hmbusch/ESP8266-WirelessSensorNetwork/README.md

# ESP8266-WirelessSensorNetwork
An ESP8266-based environment monitoring solution using wireless sensors and a graphical dashboard.
