hmbusch/ESP8266-WirelessSensorNetwork/hardware/wireless-sensor-node.brd

## EAGLE design hardware/wireless-sensor-node.brd (2016-09-16)

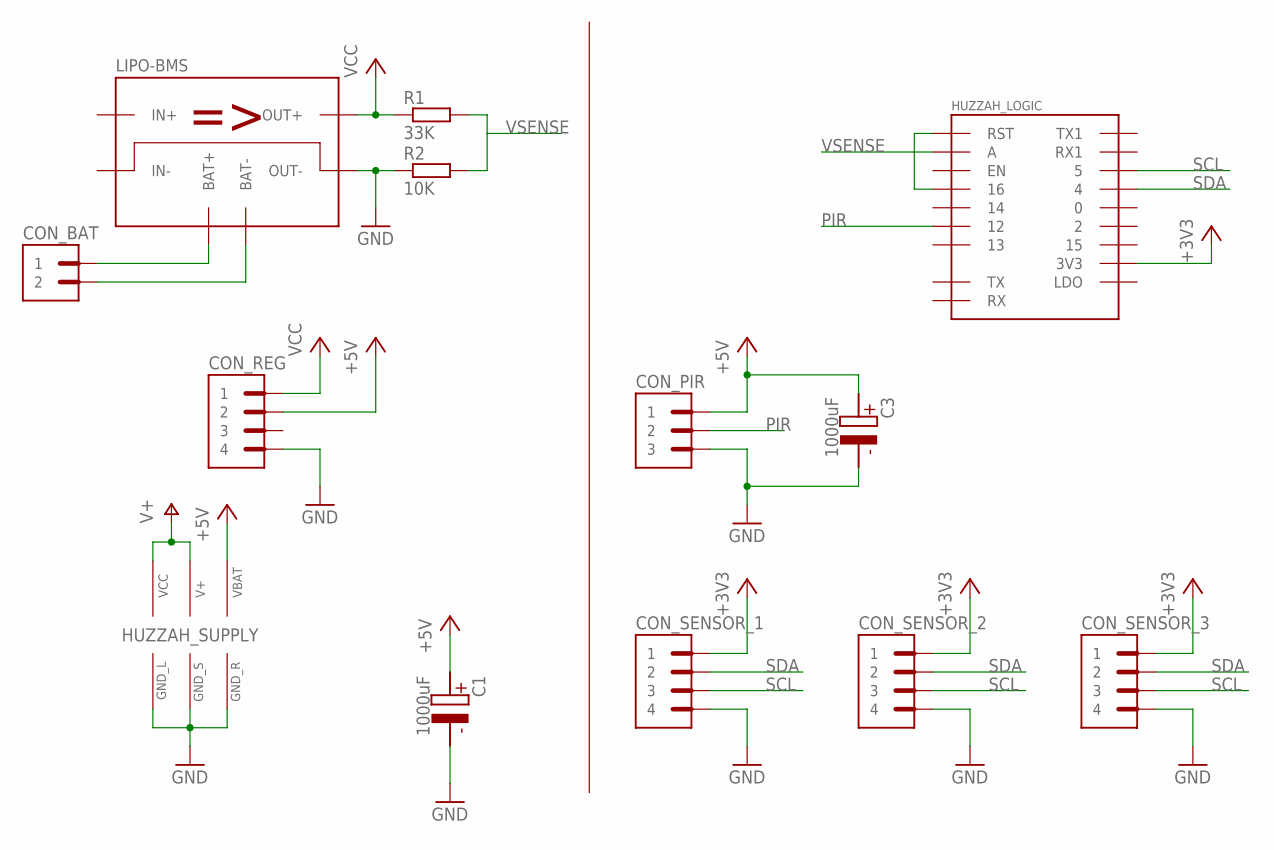
[picture p1: schematic wireless-sensor-node.sch]

Parts:
C1, C3: 1000uF; CAP_POL_10X13_5
CON_BAT: PIN_HEADER_2-WIDE; BREAKAWAY_STRAIGHT_2_WIDE
CON_PIR: PIN_HEADER_3-WIDE; BREAKAWAY_STRAIGHT_3_WIDE
CON_REG: PIN_HEADER_4-WIDE; BREAKAWAY_STRAIGHT_4_WIDE
CON_SENSOR_1, CON_SENSOR_2, CON_SENSOR_3: PIN_HEADER_4-WIDE; BREAKAWAY_STRAIGHT_4_WIDE
HUZZAH: ADAFRUIT_HUZZAH-THT-NM; ADAFRUIT_HUZZAH_NO_MOUNTS
LIPO-BMS: LIPO-BMS-CHARGER-MODULE; LIPO-BMS-CHARGER
R1: 33K; RESISTOR-1/4W-AXIAL
R2: 10K; RESISTOR-1/4W-AXIAL

Connections:
+3V3: CON_SENSOR_1.1, CON_SENSOR_2.1, CON_SENSOR_3.1, HUZZAH.3.3V (3V3)
+5V: C1.A, C3.A, CON_PIR.1, CON_REG.2, HUZZAH.VBAT
BAT+: CON_BAT.1, LIPO-BMS.BAT+
BAT-: CON_BAT.2, LIPO-BMS.BAT-
GND: C1.C, C3.C, CON_PIR.3, CON_REG.4, CON_SENSOR_1.4, CON_SENSOR_2.4, CON_SENSOR_3.4, HUZZAH.GND_L, HUZZAH.GND_R, HUZZAH.GND_S, LIPO-BMS.OUT-, R2.P$1 (1)
IN+: LIPO-BMS.IN+
IN-: LIPO-BMS.IN-
unnamed: HUZZAH.16, HUZZAH.RST
PIR: CON_PIR.2, HUZZAH.12
SCL: CON_SENSOR_1.3, CON_SENSOR_2.3, CON_SENSOR_3.3, HUZZAH.5
SDA: CON_SENSOR_1.2, CON_SENSOR_2.2, CON_SENSOR_3.2, HUZZAH.4
V+: HUZZAH.V+, HUZZAH.VCC
VCC: CON_REG.1, LIPO-BMS.OUT+, R1.P$1 (1)
VSENSE: HUZZAH.A, R1.P$2 (2), R2.P$2 (2)

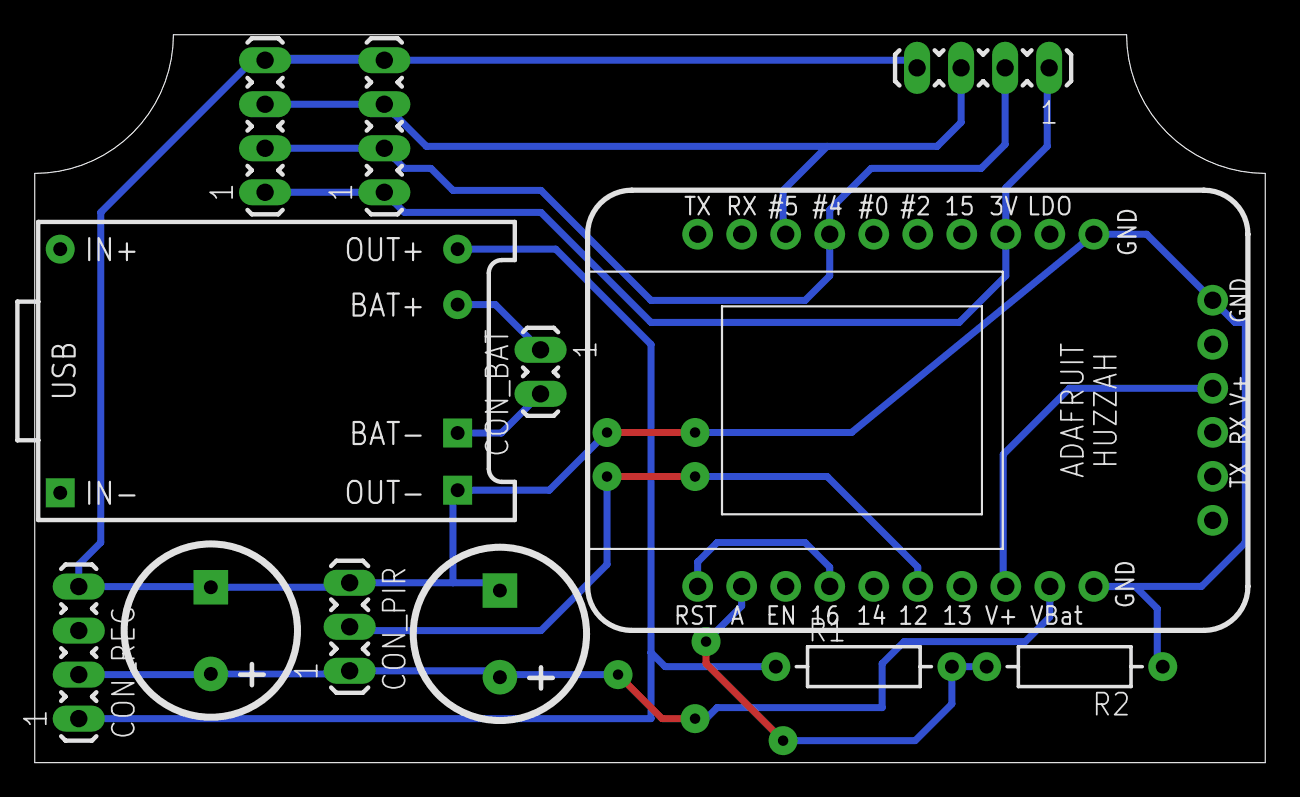
[picture p2: board wireless-sensor-node.brd from above]

Board: 2 copper layers, 71.0 x 42.0 mm, 12 parts (0 on the bottom side), 12 nets.
