hmbusch/ESP8266-WirelessSensorNetwork/software/esp8266/Wireless-Sensor/Wireless-Sensor.ino

/**
 * This sketch collects data from the attached sensors, packages it
 * and sends it to a machine running an InfluxDB. See 
 * https://influxdata.com/time-series-platform/influxdb/ for more
 * information on InfluxDB and how to set it up.
 * 
 * The node software implements a state machine for the various states,
 * from collecting to sleeping. The steps in this state machine are:
 * 
 *             + Start
 *             |
 *             v
 *     +--------------+    +-----------------+    +-----------+
 *     |              |    |                 |    |           |
 * +-->| Read sensors |--->| Connect to Wifi |--->| Send data |
 * |   |              |    |                 |    |           |
 * |   +------+-------+    +-----------------+    +-----+-----+
 * |          |                                         |
 * |          | on failure                              |
 * |          |                                         |
 * |          v                                         v
 * |   +---------------+               +----------------------+
 * |   |               |               |                      |
 * +---|    Sleep      |<--------------| Disconnect from WiFi |
 *     |               |               |                      |
 *     +---------------+               +----------------------+
 *              
 * Serial communication is enabled all the time, using 74880 
 * bauds/s. This is the same speed that the ESP8266 itself uses, so log
 * output from this sketch and from the ESP8266 itself can be viewed in
 * the same serial monitor.
 * 
 * The sensors used in the sketch are:
 * 
 * - a PIR sensor for movement (supplies HIGH or LOW an a dedicated pin)
 * - a TSL2561 for brightness measurement (via I2C)
 * - a HDC1000 for temperature and humidity measurement (via I2C)
 * - a BMP085 for barometric pressure (via I2C, optional)
 * - a BME280 for temperature, humidity and pressure (replaces the HDC1000 and BMP085,
 *   as they became harder to source. You can only use either one combination, not
 *   both at the same time)
 * - a voltage divider (33K / 10K) for the battery voltage
 * 
 * Each run of the state machine takes about 60 seconds, so one dataset
 * is created and logged roughly every minute.
 * 
 * All configuration values such as WiFi access, InfluxDB server and
 * database information, etc. have to be set in the Settings.h.
 * 
 * This version of the sketch skips the DHCP configuration of the
 * ESP8266 by using pre-configured values for IP, DNS and gateway. 
 * This saves a little time while connecting to the WiFi. And as they
 * say: time is battery power.
 * 
 * Note: the voltage divider used to measure the battery voltage is
 * only safe for up to 4.5V. Any voltage higher than that will result
 * in a voltage > 1V on the EPS's analog pin, which is only rated for
 * 1V max.
 */
#include <Wire.h>
#include <ESP8266WiFi.h>
#include <Adafruit_Sensor.h>
#include <Adafruit_TSL2561_U.h>
#include <Adafruit_BMP085_U.h>
#include <Adafruit_HDC1000.h>
#include <Adafruit_BME280.h>
#include "Settings.h"

// We need to use some ESP specific function calls not available 
// in the Arduino layer, therefore we need to import this.
extern "C" {
#include "user_interface.h"
}

// When we don't need any debug information printed, we might as
// well skip the calls in a central place - right here.
#ifdef DEBUG
  #define DEBUG_PRINT(x)    Serial.print (x)
  #define DEBUG_PRINTDEC(x) Serial.print (x, DEC)
  #define DEBUG_PRINTLN(x)  Serial.println (x)
#else
  #define DEBUG_PRINT(x)
  #define DEBUG_PRINTDEC(x)
  #define DEBUG_PRINTLN(x)
#endif 

// Enable the features for the BMP085.
#ifdef BMP085
  #define PRESSURE
#endif

// Enable the features for the HDC1000
#ifdef HDC1000
  #define TEMPERATURE
  #define HUMIDITY
#endif

// Enable the features for the BME280
#ifdef BME280
  #if defined(PRESSURE) || defined(TEMPERATURE) || defined(HUMIDITY)
    #error You have enabled more than one sensor providing pressure and/or temperature and/or humidity, please correct your configuration!
  #endif
  #define PRESSURE
  #define TEMPERATURE
  #define HUMIDITY
#endif

#ifdef PIR
  #define MOTION
#endif

const int STATE_SENSOR_READ = 0;
const int STATE_WIFI_CONNECT = 1;
const int STATE_REST_SEND = 2;
const int STATE_WIFI_DISCONNECT = 3;
const int STATE_SLEEP = 4;

int currentState = STATE_SENSOR_READ;

#ifdef TEMPERATURE
float sensorTemperature;
#endif
#ifdef HUMIDITY
float sensorHumidity;
#endif
#ifdef MOTION
boolean sensorMotion;
#endif
int sensorLux;
#ifdef PRESSURE
int sensorPressure;
#endif
int sensorVoltage;

boolean sensorReadingsValid;

long startTime = 0;

WiFiClient client;
#ifdef HDC1000
Adafruit_HDC1000 hdc = Adafruit_HDC1000();
#endif

Adafruit_TSL2561_Unified tsl = Adafruit_TSL2561_Unified(TSL2561_ADDR_FLOAT, 12345);

#ifdef BMP085
Adafruit_BMP085_Unified bmp = Adafruit_BMP085_Unified(10085);
#endif

#ifdef BME280
Adafruit_BME280 bme;
#endif

/**
 * Intializes the different sensors (using the Adafruit Unified Sensor API)
 * and the serial communication (if enabled). If the sensors are not reachable,
 * an error message is displayed on the serial monitor (if enabled).
 */
void setup() {
#ifdef DEBUG  
  Serial.begin(74880);
#endif

#ifdef PIR
  pinMode(PIN_PIR, INPUT);
  digitalWrite(PIN_PIR, LOW);
#endif

  // Configure the light sensor for auto-range and fast (but slightly inaccurate) readings
  if (tsl.begin()) {
    tsl.enableAutoRange(true);
    tsl.setIntegrationTime(TSL2561_INTEGRATIONTIME_13MS);
  }
  else {
    DEBUG_PRINTLN("[ERROR] Couldn't find any TSL2561 device, check your I2C addresses or your cabling");
    while (1);
  }

#ifdef HDC1000
  if (!hdc.begin()) {
    DEBUG_PRINTLN("[ERROR] Couldn't find any HDC1000 device, check your I2C addresses or your cabling");
    while (1);
  }
#endif

#ifdef BMP085  
  if (!bmp.begin(BMP085_MODE_ULTRALOWPOWER)) {
    DEBUG_PRINTLN("[ERROR] Couldn't find any BMP085/BMP180 device, check your I2C addresses or your cabling");
    while (1);
  }
#endif

#ifdef BME280
  if (!bme.begin(0x76)) {
    DEBUG_PRINTLN("[ERROR] Couldn't find any BME280 device, check your I2C addresses or your cabling");
    while (1);
  }
#endif
}

/**
 * Evaluates the current state of the machine and calls
 * the appropriate transition method.
 */
void loop() {
  switch (currentState)
  {
    case STATE_WIFI_CONNECT:
      handleWifiConnect();
      break;
    case STATE_SENSOR_READ:
      readSensors();
      currentState = STATE_WIFI_CONNECT;
      break;
    case STATE_REST_SEND:
      sendDataToServer();
      break;
    case STATE_WIFI_DISCONNECT:
      handleWifiDisconnect();
      break;
    case STATE_SLEEP:
      handleSleep();
      break;
    default:
      currentState = STATE_WIFI_DISCONNECT;
      break;
  }
}

/**
 * This method loops while waiting for WiFi.status() to reach WL_CONNECTED.
 * In other words: it does what it's name says: it pauses the sketch until
 * the WiFiClient signals a successful connection.
 */
void waitForConnect() {
  while (WiFi.status() != WL_CONNECTED) {
    delay(250);
    DEBUG_PRINT(".");
  }
  DEBUG_PRINTLN("done");
}

/**
 * This method configures the WiFiClient and connects to 
 * the network. It skips the DHCP process in favor of 
 * pre-configured values in order to save time.
 * Configuring the ESP8266 WiFiClient takes up a significant
 * amount of runtime (50-60% of each awake cycle) and needs
 * only to be done when the ESP is not properly configured
 * already.
 * A check is made if the ESP is already configured for the
 * given SSID and if it is, the sketch just waits for the
 * chip to automatically re-establish the network connection.
 * 
 * Note: if the WiFi SSID stays the same but the password 
 * changes, this behaviour will result in connections problems
 * because the sketch does not set the new password. I will
 * perhaps address this in a later version.
 */
void handleWifiConnect() {
  DEBUG_PRINTLN();
  DEBUG_PRINTLN();

  // IP configuration has to be done everytime, otherwise the
  // ESP will simply use DHCP
  WiFi.config(WIFI_IP, WIFI_DNS, WIFI_GATEWAY);

  if (WiFi.SSID().equalsIgnoreCase(WIFI_SSID)) {
    
    DEBUG_PRINT("Already configured for: ");
    DEBUG_PRINT(WiFi.SSID());
    DEBUG_PRINT(". Waiting for connect");
    waitForConnect();
  }
  else {
    DEBUG_PRINT("Connecting to ");
    DEBUG_PRINT(WIFI_SSID);
    DEBUG_PRINT("...");
    
    // Configure IPs to save time during connect by omitting the DHCP negotiation
    WiFi.mode(WIFI_STA);

    // Connect
    WiFi.begin(WIFI_SSID, WIFI_KEY);
    // Tell the ESP to auto-reconnect to the configured WiFi network
    wifi_station_set_auto_connect(true);
    waitForConnect();
  }

  DEBUG_PRINTLN();
  DEBUG_PRINT("IP address: ");
  DEBUG_PRINTLN(WiFi.localIP());
  DEBUG_PRINTLN();

  // Transition to the next state
  currentState = STATE_REST_SEND;
}

/**
 * Performs a TCP connect to the server and packages the
 * sensor information as an InfluxDB line data package. This line is then
 * POSTed to the server. If the request does not return within the 
 * configured timeout, the operation is aborted and the program continues.
 * Any response from the server is printed to Serial (if enabled).
 * 
 * Pressure data is only included if a pressure sensor is available.
 */
void sendDataToServer() {
  boolean successfullyConnected = client.connect(INFLUX_HOST, INFLUX_PORT);
  if (successfullyConnected) {
    DEBUG_PRINT("Sending POST request to http://");
    DEBUG_PRINT(INFLUX_HOST);
    DEBUG_PRINT(":");
    DEBUG_PRINT(INFLUX_PORT);
    DEBUG_PRINTLN(INFLUX_URL);

  
    String requestBody = String("sensor,source-id=") + SENSOR_ID + " ";
#ifdef TEMPERATURE
    requestBody = requestBody + "temperature=" + sensorTemperature + ",";
#endif
#ifdef HUMIDITY
    requestBody = requestBody + "humidity=" + sensorHumidity + ",";
#endif
    requestBody = requestBody + "brightness=" + sensorLux + ",";
#ifdef MOTION    
    requestBody = requestBody + "movement=" + (sensorMotion ? "1" : "0") + ",";
#endif
#ifdef PRESSURE
    requestBody = requestBody + "pressure=" + sensorPressure + ",";
#endif
    requestBody = requestBody + "voltage=" + sensorVoltage;

    // use static request at the moment
    client.print("POST ");
    client.print(INFLUX_URL);
    client.print("?db=");
    client.print(INFLUX_DB_NAME);
    client.print("&rp=");
    client.print(INFLUX_RETENTION_POLICY);
    client.println(" HTTP/1.1");
    client.print("Host: ");
    client.print(INFLUX_HOST);
    client.print(":");
    client.println(INFLUX_PORT);
    client.println("Connection: close");
    client.print("Content-Length: ");
    client.println(requestBody.length());
    client.println();
    client.println(requestBody);

    DEBUG_PRINTLN("Request sent");

    int gracePeriod = millis() + HTTP_TIMEOUT;
    boolean aborted = false;
    while (client.available() == 0 && !aborted) {
      if (millis() > gracePeriod) {
        DEBUG_PRINTLN("Request timed out, aborting...");
        client.stop();
        aborted = true;
      }
      delay(50);
    }

    if (!aborted) {
      // give the server a little more time to complete the response
      delay(100);
      DEBUG_PRINT("Received ");
      DEBUG_PRINTDEC(client.available());
      DEBUG_PRINTLN(" bytes");
      DEBUG_PRINTLN();
      // We'll display the response for debugging purposed. Until we have a decent response parser,
      // we might as well flush() the client and throw away the data.
      while (client.available()) {
        String line = client.readStringUntil('\r');
        DEBUG_PRINT(line);
      }
    }
  }
  else {
    DEBUG_PRINT("Could not connect to ");
    DEBUG_PRINT(INFLUX_HOST);
    DEBUG_PRINT(":");
    DEBUG_PRINTLN(INFLUX_PORT);
    DEBUG_PRINTLN();
  }

  // Transition to the next state
  currentState = STATE_WIFI_DISCONNECT;
}

/**
 * This is now a noop method. When the ESP enters deep sleep, the network
 * connection is lost anyways and shutting it down manually interferes with
 * the auto-reconnect feature. 
 * This method now immediately transistions to the next steps and will 
 * probably be removed in a future version.
 */
void handleWifiDisconnect() {
  // Transition to the next state
  currentState = STATE_SLEEP;
}

/**
 * This method puts the ESP8266 into deep sleep mode for power saving. To
 * achieve the "one measurement per minute" precision, the runtime of the
 * last cycle is subtracted from 60 seconds and the remainder is used as
 * deep sleep time.
 */
void handleSleep() {
  int cycleTime = millis() - startTime;
  DEBUG_PRINT("Operating cycle time: ");
  DEBUG_PRINT(cycleTime);
  DEBUG_PRINTLN(" milliseconds");
  DEBUG_PRINTLN("Sleeping... zZzZzZ");
  DEBUG_PRINTLN();
  ESP.deepSleep(60 * 1000000 - cycleTime, WAKE_RF_DEFAULT);
  // Do not remove this delay. The ESP will not enter deep sleep
  // correctly without it.  
  delay(100);
}

/**
 * Reads the indiviual sensors and assigns their values to the
 * corresponding global variables.
 */
void readSensors() {
  startTime = millis();
  
  DEBUG_PRINTLN("Reading Sensors...");
  
  sensorReadingsValid = false;

#ifdef HDC1000
  // Read the HDC1000
  sensorTemperature = hdc.readTemperature();
  sensorHumidity = hdc.readHumidity();
#endif

#ifdef PIR
  // Read the PIR Sensor
  sensorMotion = HIGH == digitalRead(PIN_PIR);
#endif

  // Read the light sensor
  sensors_event_t lightEvent;
  tsl.getEvent(&lightEvent);
  if (lightEvent.light > 0) {
    sensorLux = lightEvent.light;     
  }
  else {
    sensorLux = 0;
  }

#ifdef BMP085
  // Read the pressure sensor
  sensors_event_t pressureEvent;
  bmp.getEvent(&pressureEvent);
  if (pressureEvent.pressure > 0) {
    sensorPressure = pressureEvent.pressure;
  }
  else {
    sensorPressure = 0;
  }
#endif

#ifdef BME280
  // Read the BME280
  sensorPressure = bme.readPressure() / 100.0F;
  if (sensorPressure < 0) {
    sensorPressure = 0;
  }
  sensorTemperature = bme.readTemperature();
  sensorHumidity = bme.readHumidity();
#endif

  // Read the voltage (given a Vbat -> 33K -> A -> 10K -> GND
  // voltage divider that is safe up to 4.5V)
  // Do several readings the reduce jitter.
  sensorVoltage = 0;
  int smoothedAnalogValue = 0;
  for (int i = 0; i < 5; i++) {
    int analogValue = analogRead(A0);
    smoothedAnalogValue += analogValue;
    delay(10);
  }
  smoothedAnalogValue = smoothedAnalogValue / 5;
  int dividedMillivolts = map(smoothedAnalogValue, 0, 1023, 0, 1000);
  sensorVoltage = dividedMillivolts * VOLTAGE_RATIO;

  // just set this to true, maybe we'll add functionality later on
  sensorReadingsValid = true;

#ifdef TEMPERATURE
  DEBUG_PRINT("Temperature: ");
  #ifdef HDC1000
    DEBUG_PRINT(hdc.readTemperature());
  #endif
  #ifdef BME280
    DEBUG_PRINT(bme.readTemperature());
  #endif
  DEBUG_PRINT(" (");
  DEBUG_PRINT(sensorTemperature);
  DEBUG_PRINTLN(" °C)");
#endif
#ifdef HUMIDITY
  DEBUG_PRINT("Humidity: ");
  #ifdef HDC1000
    DEBUG_PRINT(hdc.readHumidity());
  #endif
  #ifdef BME280
    DEBUG_PRINT(bme.readHumidity());
  #endif
  DEBUG_PRINT(" (");
  DEBUG_PRINT(sensorHumidity);
  DEBUG_PRINTLN("%)");
#endif
  DEBUG_PRINT("Brightness: ");
  DEBUG_PRINT(lightEvent.light);
  DEBUG_PRINT(" (");
  DEBUG_PRINT(sensorLux);
  DEBUG_PRINTLN(" lux)");
#ifdef MOTION  
  DEBUG_PRINT("Movement: ");
  DEBUG_PRINTLN(sensorMotion ? "true" : "false");
#endif
#ifdef PRESSURE  
  DEBUG_PRINT("Pressure: ");
  #ifdef BMP085  
    DEBUG_PRINT(pressureEvent.pressure);
  #endif
  #ifdef BME280
    DEBUG_PRINT(bme.readPressure() / 100.F);
  #endif
  DEBUG_PRINT(" (");
  DEBUG_PRINT(sensorPressure);
  DEBUG_PRINTLN(")");
#endif  
  DEBUG_PRINT("Voltage: ");
  DEBUG_PRINT(smoothedAnalogValue);
  DEBUG_PRINT(" (");
  DEBUG_PRINT(sensorVoltage);
  DEBUG_PRINTLN(" mV)");
  
  DEBUG_PRINTLN("done");
  
  // Transition to the next state
  if (sensorReadingsValid) {
    DEBUG_PRINTLN("Sensors read OK, proceeding to WiFi connect");
    currentState = STATE_WIFI_CONNECT;  
  }
  else {
    DEBUG_PRINTLN("Sensor reading failed, proceeding directly to sleep");
    currentState = STATE_SLEEP;
  }
  Serial.println();
}
