hmbusch/ESP8266-WirelessSensorNetwork/(commit log)

2016-07-26 Created circuit and PCB for the sensor with EAGLE
    [wireless-sensor-node.brd, wireless-sensor-node.sch]
2016-08-14 Added deep sleep capabilities to the ESP8266 sketch.
    The previously non-existent 'read sensors' step was added
    as a distinct method. It still uses static data, but the
    sketch can already combine and package individual sensor
    readings in to a single JSON document to send to the server.
2016-08-14 The ESP8266 sketch now reads real sensors
    It also transmits real data using three different sensors
    for movement, temperature & humidtity and brightness.
2016-08-15 Sensor data is now sent directly to an InfluxDB
    Why write another time series REST service when
    there are databases like InfluxDB that exactly
    do what we need.
    The sketch was migrated to write to the InfluxDB.
    In addition, a sensor now has a readable ID, which
    allows us to distinguish individual datasets in the
    InfluxDB.
    Serial communication for debugging purposes is now
    disabled by default. You need to uncomment the
    corresponding preprocessor token in the Settings.h
    to enable it.
2016-08-15 Added a pressure sensor & static IPs
    In an effort to reduce power consumption by minimizing
    on times, I switched from DHCP to static IP configuration.
    It saves a little time, but still not enough to realize
    decent battery life (I run a sensor node on a single 18650
    lithium ion cell). I still have to tweak the code, but this
    is at least a first step.
    I also added a BMP085 barometric pressure sensor to the
    setup. With that, a single node can determine all relevant
    environmental information.
2016-08-15 Improved battery life with better connection handling
    Turns out the key to reducing the on time of the sketch
    was to not configure the ESPs network settings when they
    were already configured. This configuration process
    accounted for 50-60% of the total runtime. Now, the ESP
    is only configured when it's SSID differs from the
    configured one. In addition, disconnecting from the
    network is not really neccessary and thus was removed.
    A single activity cycle now takes only 3-5 seconds.
2016-08-15 Added a voltage detection to the sketch
    With an appropriate voltage divider, the sketch can now
    determine and log the current battery voltage.
2016-08-15 Optional pressure readings, better battery voltage
    When deployed in a homestead, it doesn't make sense to equip
    each node with a pressure sensor because the air pressure will
    not vary in such a small area. To accomodate nodes without
    pressure sensors, the sensor can be enabled or disabled via the
    settings file.
    The battery voltage is now read several times and the average value
    is used. This should smoothen 'jumpy' voltage readings.
    [Settings.h, Wireless-Sensor.ino]
2016-09-15 Added support for the BME280 sensor
    You can now select which sensors to use by commenting/uncommenting
    their definition in the settings. You cannot enable more than one
    sensor for a given indicator, e.g. you can either use the HDC1000
    or the BME280 to measure temperature and humidity but not both.
    Also fixed the static IP address assignment. When reconnecting,
    WiFi is unconfigured in terms of IP, so the proper configuration
    to bypass DHCP has to run always.
    [Settings.h, Wireless-Sensor.ino]
2016-09-16 Redesigned the board to accomodate an BME280 sensor
    The BME280 can now directly attach to the top connecor
    (I will have to verify the pinout still, though).
    Also corrected the voltage divider, I had the resistors
    unintentionally the wrong way round (10K -> 33K instead of
    33K -> 10K), thus exposing the analog pin to far higher
    voltages than intended.
    [wireless-sensor-node.brd, wireless-sensor-node.sch]
2016-09-18 Optimized battery voltage detection
    Also set an explicit BME280 I2C address. The driver default is
    0x77, my sensor from China uses 0x76 by default, so I had to
    specify that.
    Battery voltage calculation is now down outside of the measuring
    loop to reduce the amount of operations and to reduce rouding
    induced inaccuracies.
2016-09-19 Various improvements (see comment for details)
    IP configuration is now done during every run, otherwise DHCP
    would be used for each run after the initial. That also means
    that the static configuration was not working until now. D'oh!
    Allowed enabling/disabling of the PIR sensor. Until I have found
    a pratical solution to suppress the large amount of RF-induced
    false triggerings, I at least want to be able to switch that
    thing of.
    Runtime + deep sleep time now add up to a minute exactly. The
    time for each run cycle is measured and the neccessary sleep time
    to achieve 1 minute in total is calculated from that.
    Replaces a verbatim Serial.print() with DEBUG_PRINT().
    [Settings.h, Wireless-Sensor.ino]
2021-06-07 Added first version of Arduino CI workflow
2021-06-07 Hopefully fixed boards url for esp8266 in CI
2021-06-07 Fixed Arduino library names for CI
2021-06-07 Set correct path to sketches for Arduino CI
