hmbusch/ESP8266-WirelessSensorNetwork/(notices)

Notices in the files:
parts and their libraries:
icmi-custom-parts: ICMI Custom Parts for EAGLE by Hendrik Busch is licensed under a Creative Commons
Attribution-NonCommercial-ShareAlike 3.0 Germany License.
